neoyong/color-spu-strip/colorspu-hardware-v1.1r1/spu-back-1.1r1.png

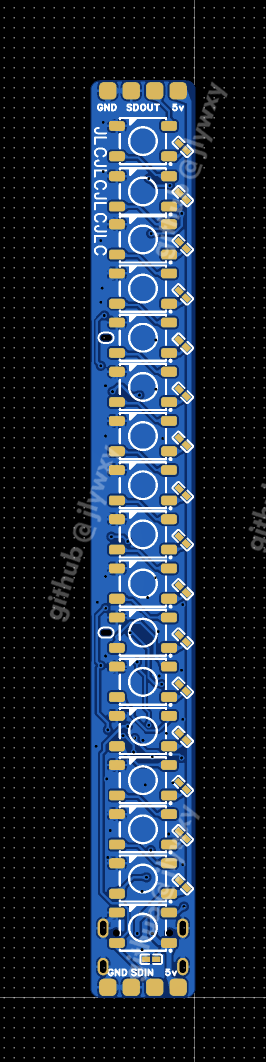
colorspu-hardware-v1.1r1/spu-back-1.1r1.png
