neoyong/color-spu-strip/(list of files, drawings)

Other design files:
colorspu-hardware-v1.1r1/color-spu-strip-1.1-1019.eprj
