neoyong/color-spu-strip/colorspu-firmware-v2.0/memstest.ioc

Mcu.UserName=STM32G030F6Px
PA1.Signal=SPI1_SCK
PA13.Signal=SYS_SWDIO
PA14-BOOT0.Signal=SYS_SWCLK
PA5.Signal=GPXTI5
PA6.Signal=SPI1_MISO
PA7.Signal=GPXTI7
PA8.Signal=S_TIM1_CH1
