neoyong/color-spu-strip/(commit log)

2022-10-24 最终版本（1.1+1.1rev1）
2023-01-30 firmware v2.0 + hardware v1.1r1
    [color-spu-strip-1.1-1019.eprj, st_nucleo_g0.cfg]
